KayuranN/EEE4022S_PrecisonHerbicideSprayer/README.md

# EEE4022S_PrecisonHerbicideSprayer
Repository containing all files used in the project development of the Precision Herbicide Sprayer
