KayuranN/EEE4022S_PrecisonHerbicideSprayer/Modeled Components/Camera System/AssemblyofGears.SLDASM

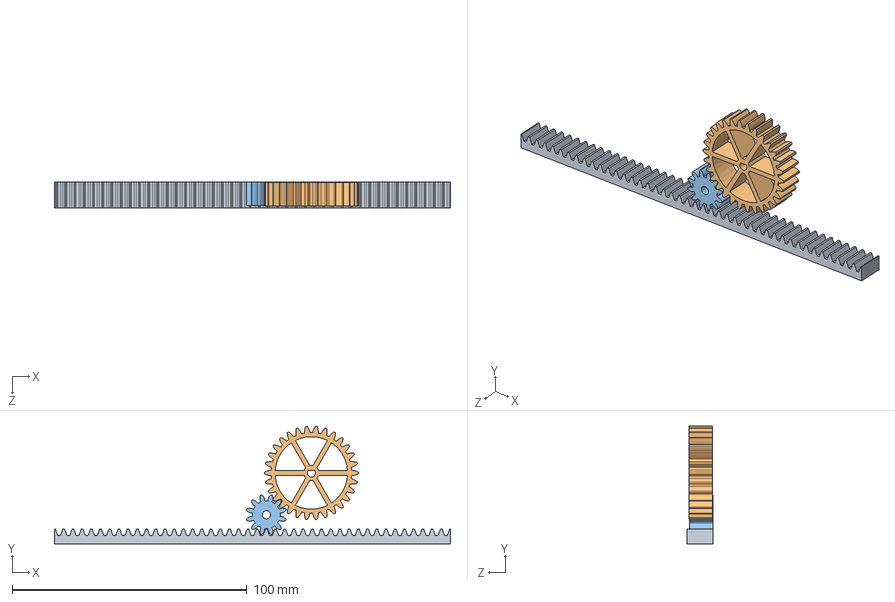
[picture p43: CAD file, 2023-10-29]
Modeled Components/Camera System/AssemblyofGears.SLDASM
168.9 x 50.1 x 11.0 mm
Rack169cm
BigGear
SmallGear
