KayuranN/EEE4022S_PrecisonHerbicideSprayer/Modeled Components/Actuation Arms/armReference.STL

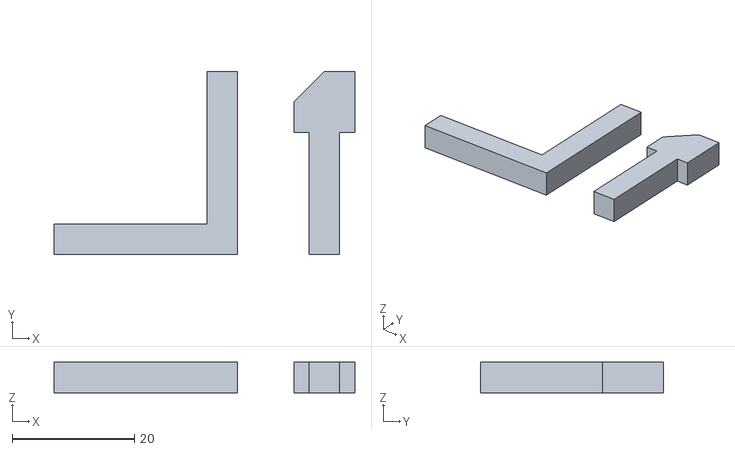
[picture p44: CAD file, 2023-10-29]
Modeled Components/Actuation Arms/armReference.STL
49.2 x 30.0 x 5.00
