KayuranN/EEE4022S_PrecisonHerbicideSprayer/Modeled Components/Uncategorized Parts/TPipeConnector.SLDPRT

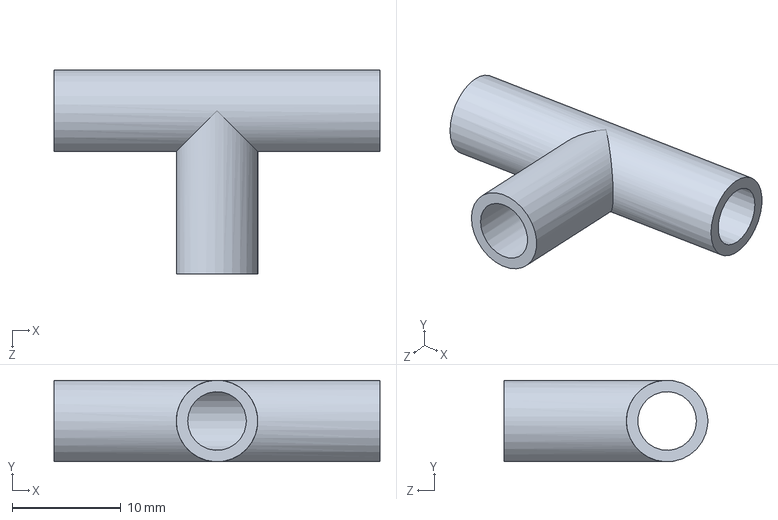
[picture p45: CAD file, 2023-10-29]
Modeled Components/Uncategorized Parts/TPipeConnector.SLDPRT
30.0 x 7.50 x 18.8 mm
