KayuranN/EEE4022S_PrecisonHerbicideSprayer/Modeled Components/Actuation Arms/housingBoxV2.2.SLDPRT

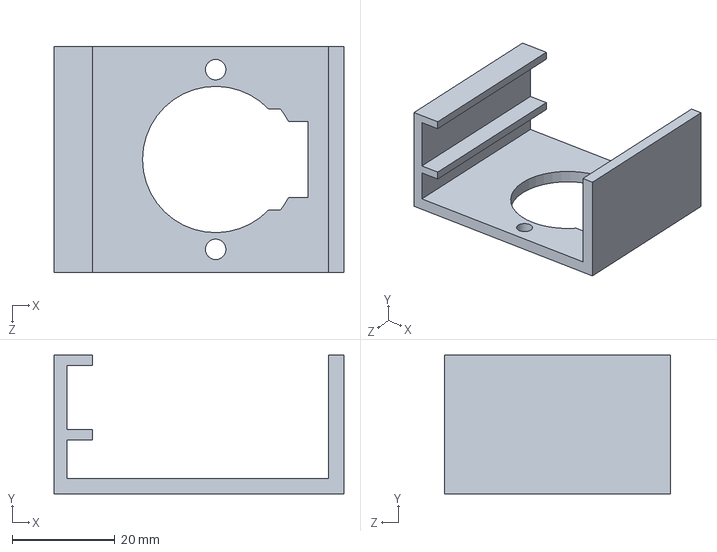
[picture p46: CAD file, 2023-10-29]
Modeled Components/Actuation Arms/housingBoxV2.2.SLDPRT
56.5 x 27.0 x 44.0 mm
