KayuranN/EEE4022S_PrecisonHerbicideSprayer/Modeled Components/Camera System/BigGear.SLDPRT

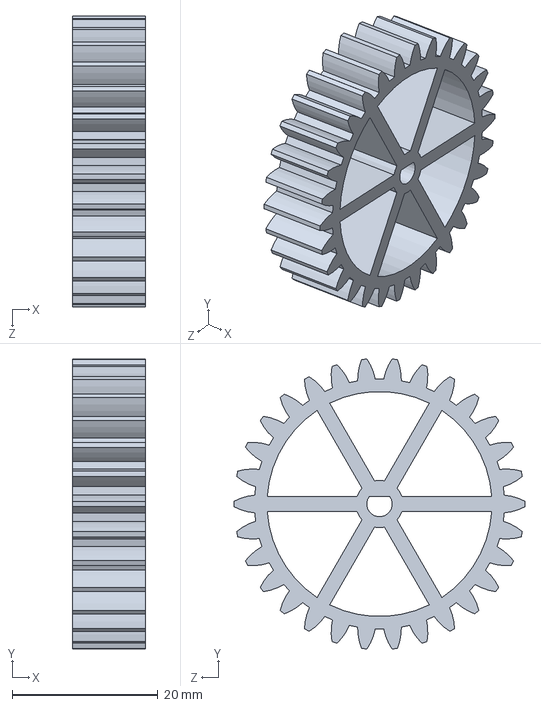
[picture p47: CAD file, 2023-10-29]
Modeled Components/Camera System/BigGear.SLDPRT
10.0 x 39.9 x 40.0 mm
