KayuranN/EEE4022S_PrecisonHerbicideSprayer/Modeled Components/Uncategorized Parts/wheelholder.SLDPRT

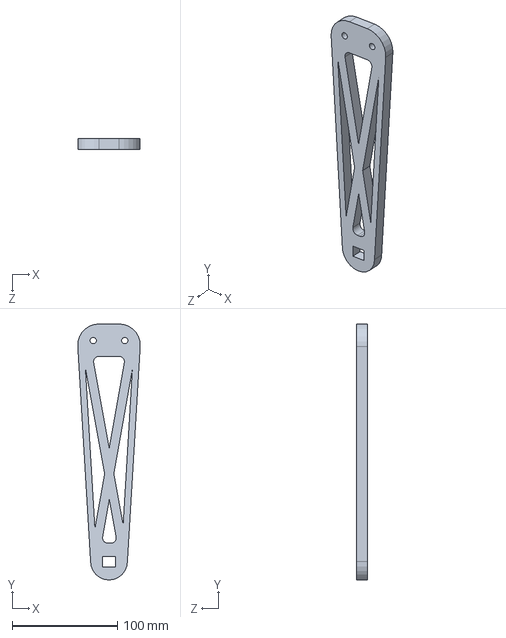
[picture p48: CAD file, 2023-10-29]
Modeled Components/Uncategorized Parts/wheelholder.SLDPRT
59.4 x 243.3 x 10.0 mm
