KayuranN/EEE4022S_PrecisonHerbicideSprayer/Modeled Components/Actuation Arms/MotorHolder.SLDPRT

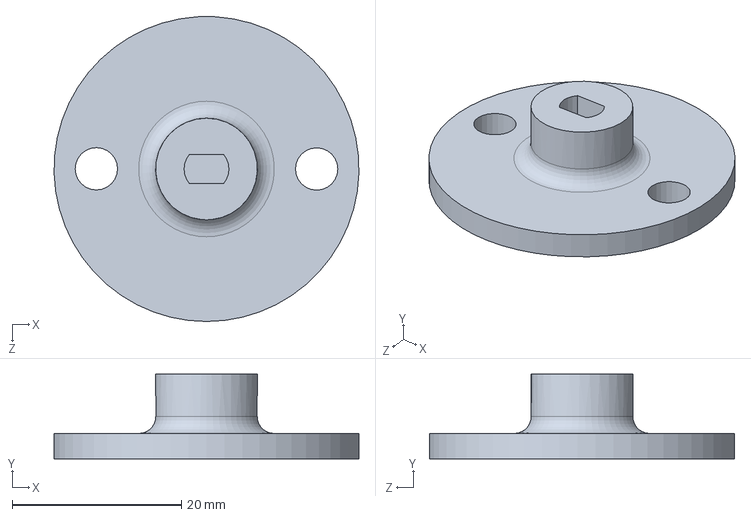
[picture p49: CAD file, 2023-10-29]
Modeled Components/Actuation Arms/MotorHolder.SLDPRT
36.0 x 10.0 x 36.0 mm
