KayuranN/EEE4022S_PrecisonHerbicideSprayer/Modeled Components/Camera System/MotorHolder.SLDPRT

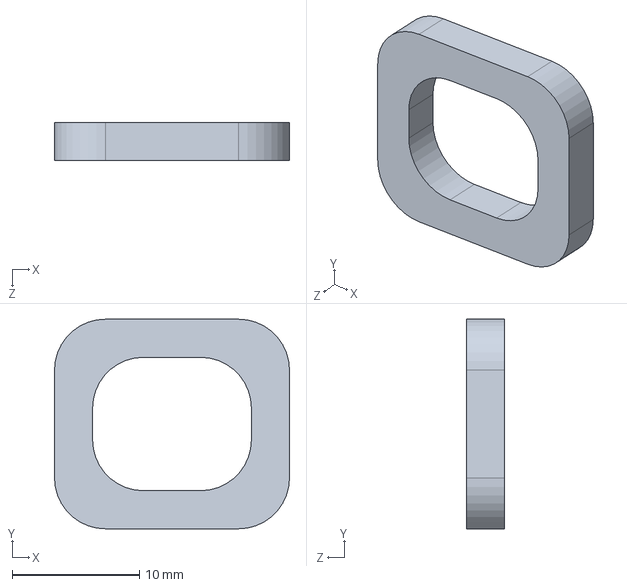
[picture p50: CAD file, 2023-10-29]
Modeled Components/Camera System/MotorHolder.SLDPRT
18.5 x 16.5 x 3.00 mm
