KayuranN/EEE4022S_PrecisonHerbicideSprayer/Modeled Components/Uncategorized Parts/wheelholderEnd.SLDPRT

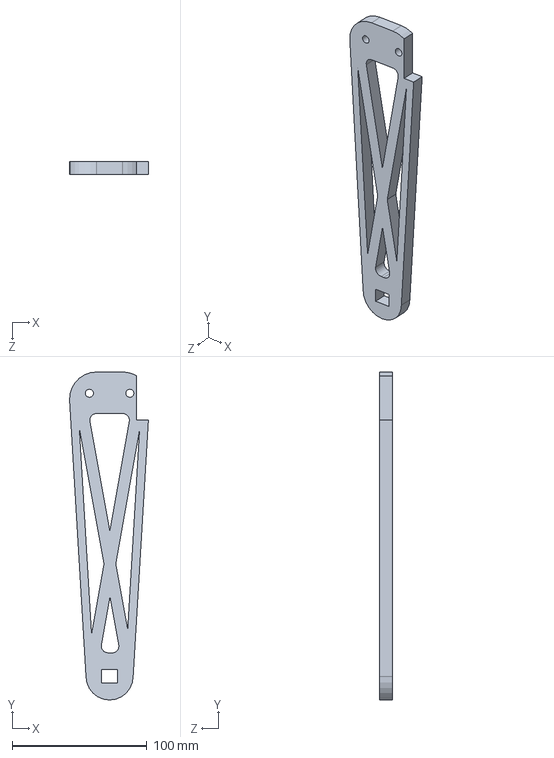
[picture p51: CAD file, 2023-10-29]
Modeled Components/Uncategorized Parts/wheelholderEnd.SLDPRT
58.5 x 243.3 x 10.0 mm
