KayuranN/EEE4022S_PrecisonHerbicideSprayer/Modeled Components/Actuation Arms/RackV3.2.STL

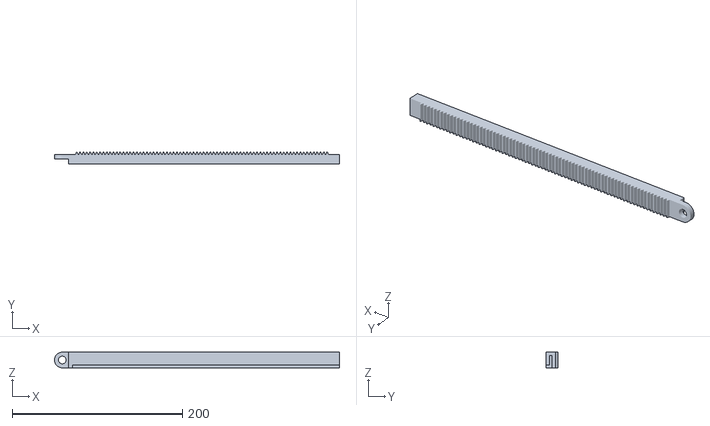
[picture p52: CAD file, 2023-10-29]
Modeled Components/Actuation Arms/RackV3.2.STL
335.2 x 14.2 x 18.5
