KayuranN/EEE4022S_PrecisonHerbicideSprayer/Modeled Components/Camera System/Rack169cm.SLDPRT

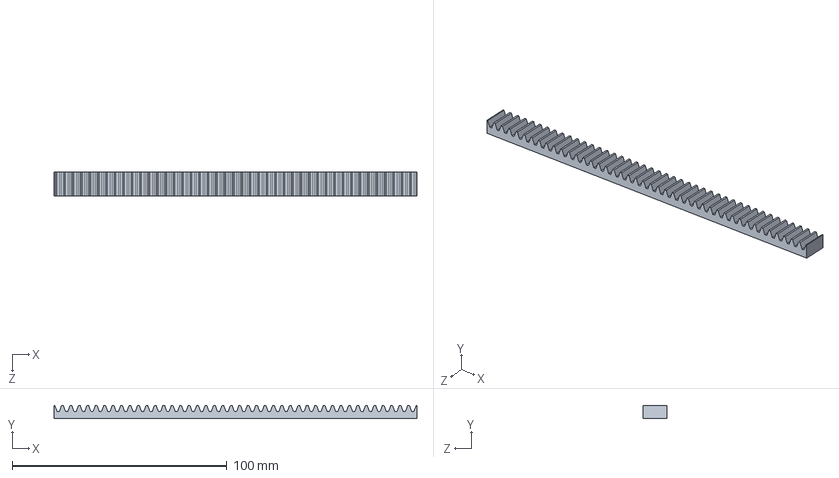
[picture p53: CAD file, 2023-10-29]
Modeled Components/Camera System/Rack169cm.SLDPRT
168.9 x 6.25 x 11.0 mm
