KayuranN/EEE4022S_PrecisonHerbicideSprayer/Modeled Components/Uncategorized Parts/wheelholderMiddle.SLDPRT

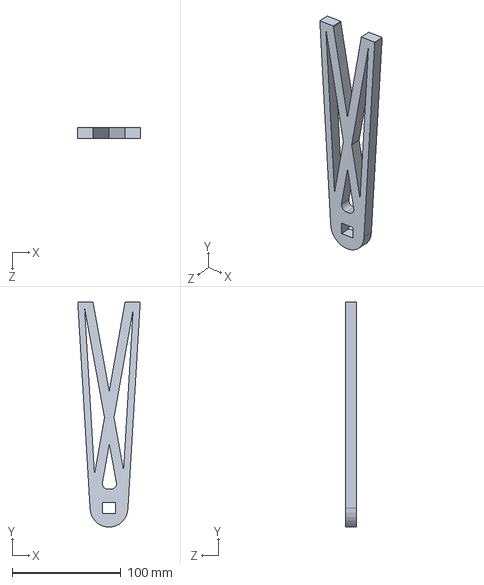
[picture p54: CAD file, 2023-10-29]
Modeled Components/Uncategorized Parts/wheelholderMiddle.SLDPRT
57.6 x 207.4 x 10.0 mm
