KayuranN/EEE4022S_PrecisonHerbicideSprayer/Modeled Components/Actuation Arms/rotationalHousing.SLDPRT

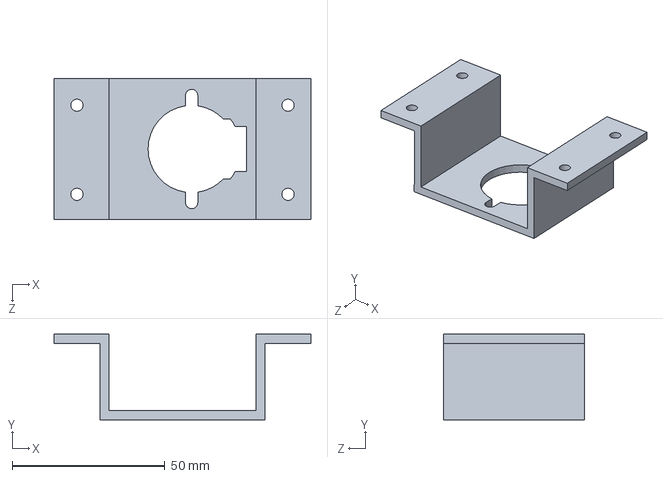
[picture p55: CAD file, 2023-10-29]
Modeled Components/Actuation Arms/rotationalHousing.SLDPRT
84.0 x 28.0 x 46.0 mm
