KayuranN/EEE4022S_PrecisonHerbicideSprayer/Modeled Components/Camera System/housingUnitUnder.SLDPRT

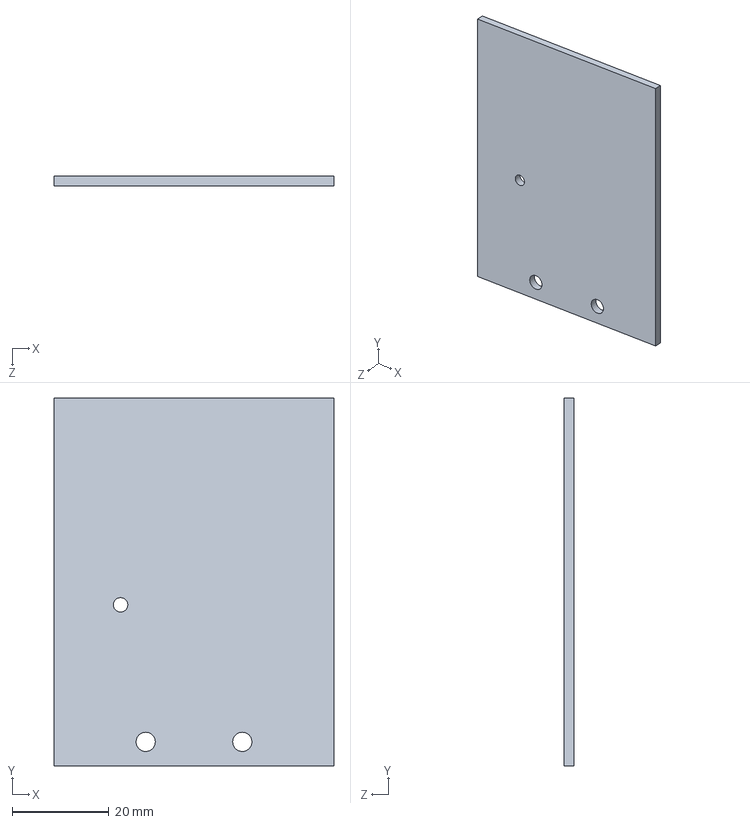
[picture p56: CAD file, 2023-10-29]
Modeled Components/Camera System/housingUnitUnder.SLDPRT
57.9 x 76.2 x 2.00 mm
