KayuranN/EEE4022S_PrecisonHerbicideSprayer/Modeled Components/Uncategorized Parts/Nozzle+.SLDPRT

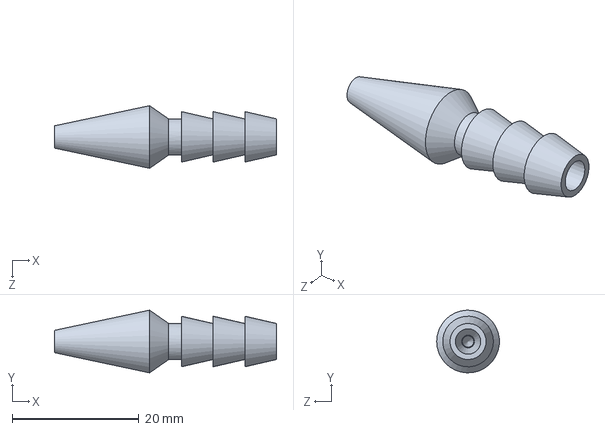
[picture p57: CAD file, 2023-10-29]
Modeled Components/Uncategorized Parts/Nozzle+.SLDPRT
35.0 x 9.89 x 9.88 mm
