KayuranN/EEE4022S_PrecisonHerbicideSprayer/Modeled Components/Actuation Arms/rotationalHousingShort.SLDPRT

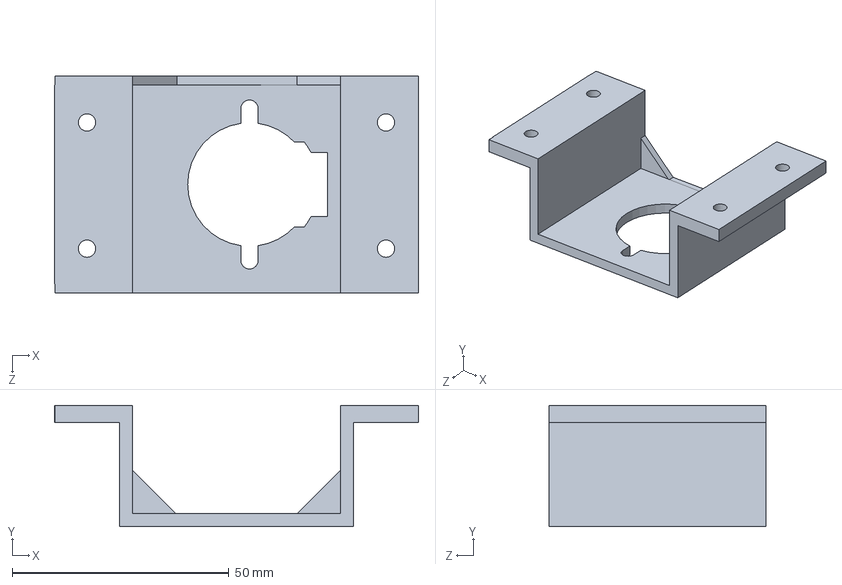
[picture p58: CAD file, 2023-10-29]
Modeled Components/Actuation Arms/rotationalHousingShort.SLDPRT
84.0 x 28.0 x 50.0 mm
