KayuranN/EEE4022S_PrecisonHerbicideSprayer/Modeled Components/Camera System/Slider.SLDPRT

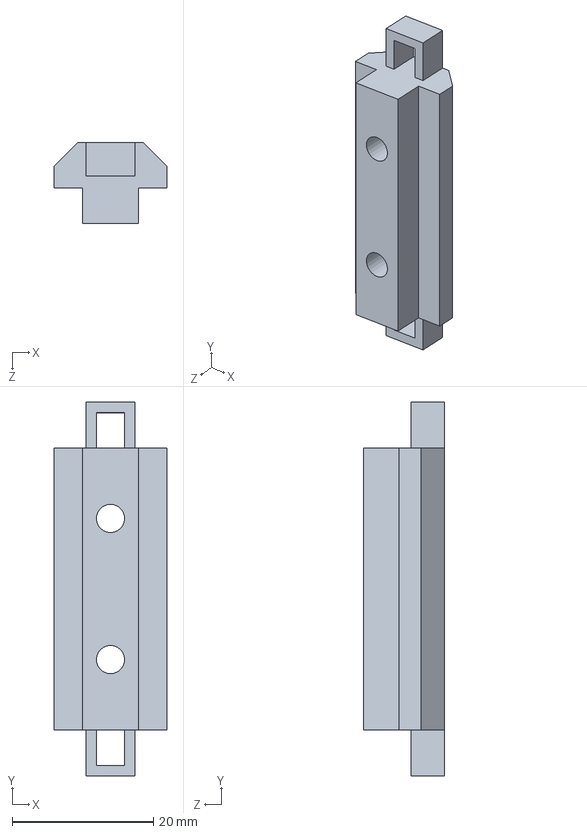
[picture p59: CAD file, 2023-10-29]
Modeled Components/Camera System/Slider.SLDPRT
16.0 x 53.0 x 11.5 mm
