KayuranN/EEE4022S_PrecisonHerbicideSprayer/Modeled Components/Actuation Arms/rotationalHousingTall.SLDPRT

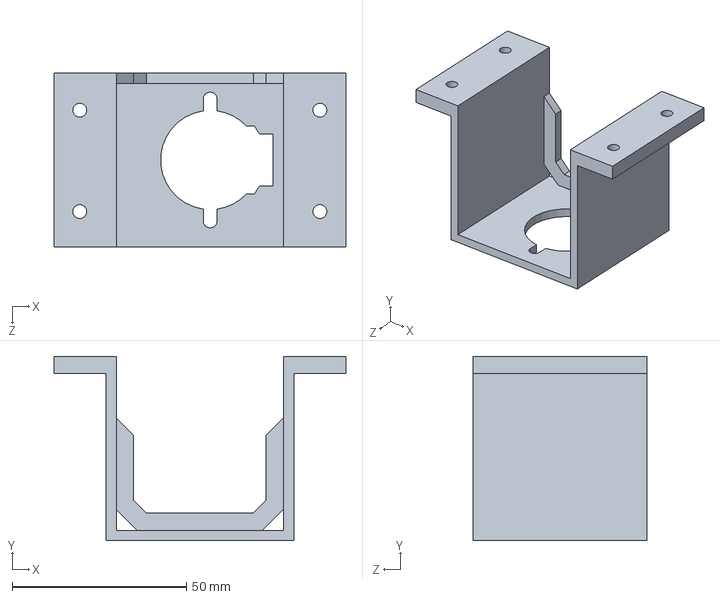
[picture p60: CAD file, 2023-10-29]
Modeled Components/Actuation Arms/rotationalHousingTall.SLDPRT
83.9 x 53.0 x 50.0 mm
