KayuranN/EEE4022S_PrecisonHerbicideSprayer/Modeled Components/Camera System/RawGears2.SLDPRT

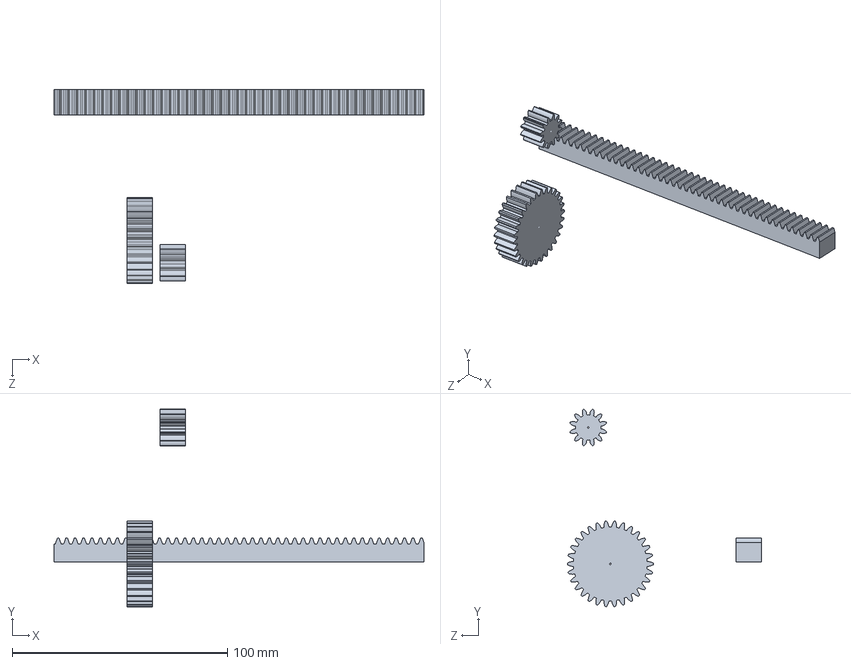
[picture p61: CAD file, 2023-10-29]
Modeled Components/Camera System/RawGears2.SLDPRT
172.0 x 91.9 x 90.4 mm
