KayuranN/EEE4022S_PrecisonHerbicideSprayer/Modeled Components/Uncategorized Parts/LPipeConnector.SLDPRT

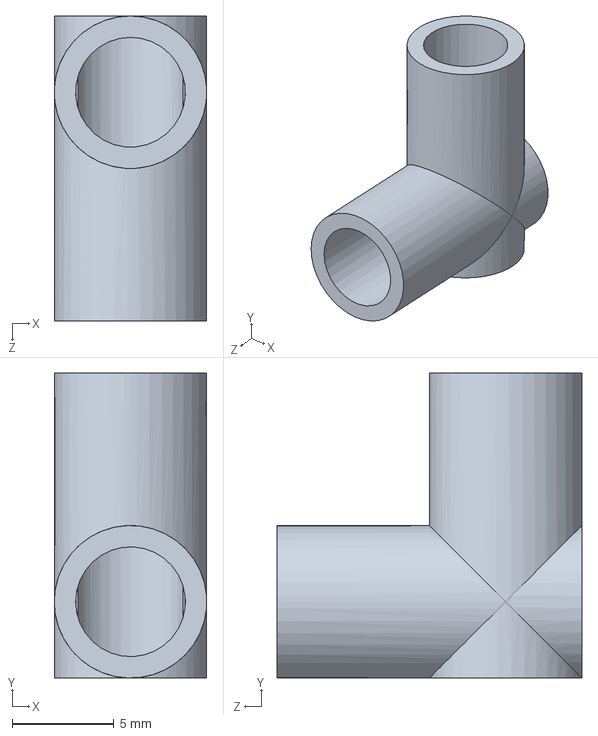
[picture p62: CAD file, 2023-10-29]
Modeled Components/Uncategorized Parts/LPipeConnector.SLDPRT
7.50 x 15.0 x 15.0 mm
