KayuranN/EEE4022S_PrecisonHerbicideSprayer/Modeled Components/Actuation Arms/RackKey.SLDPRT

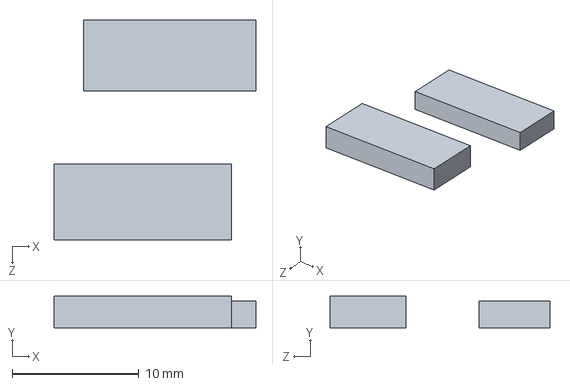
[picture p63: CAD file, 2023-10-29]
Modeled Components/Actuation Arms/RackKey.SLDPRT
15.9 x 2.50 x 17.4 mm
