KayuranN/EEE4022S_PrecisonHerbicideSprayer/Modeled Components/Camera System/rackHolder1mmshorter.SLDPRT

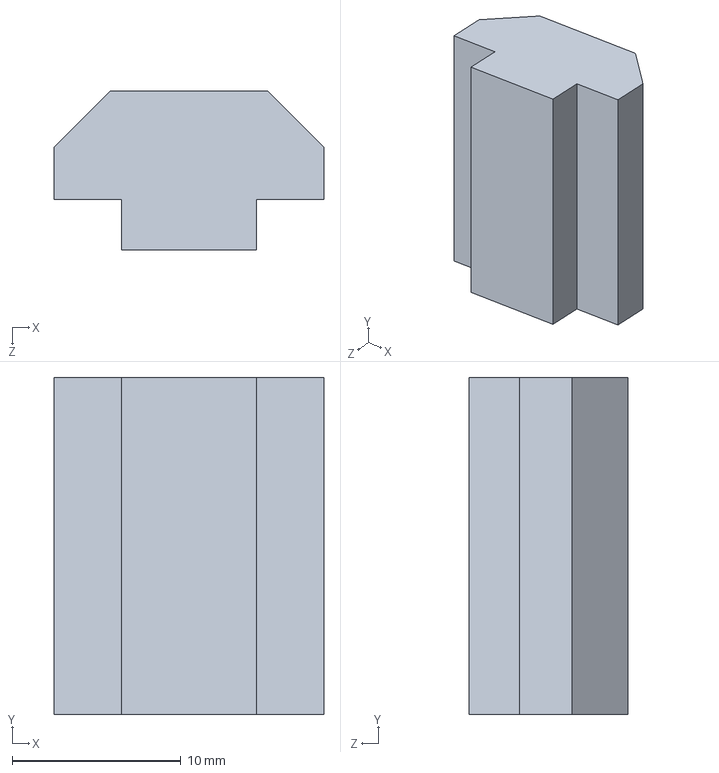
[picture p64: CAD file, 2023-10-29]
Modeled Components/Camera System/rackHolder1mmshorter.SLDPRT
16.0 x 20.0 x 9.46 mm
