KayuranN/EEE4022S_PrecisonHerbicideSprayer/Modeled Components/Actuation Arms/RackAndPinionV2.2.SLDPRT

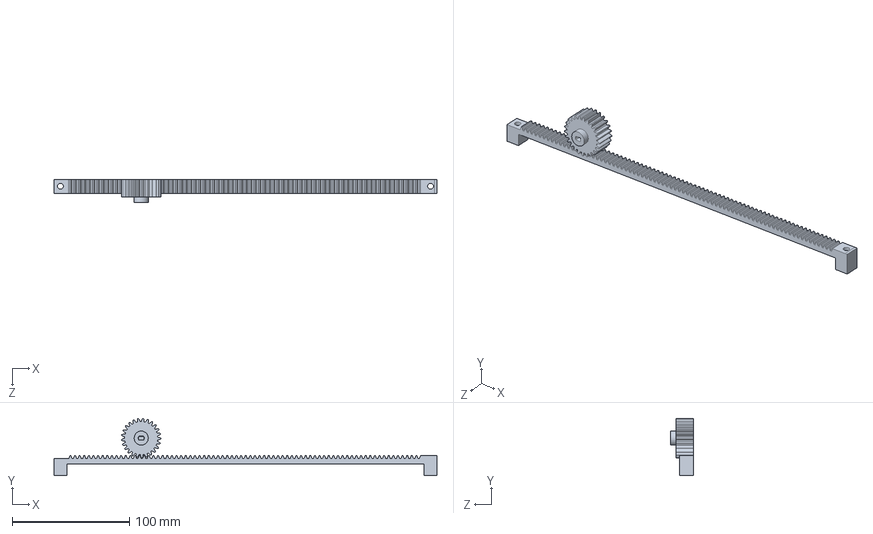
[picture p65: CAD file, 2023-10-29]
Modeled Components/Actuation Arms/RackAndPinionV2.2.SLDPRT
326.0 x 48.8 x 20.0 mm
