KayuranN/EEE4022S_PrecisonHerbicideSprayer/Modeled Components/Camera System/housingUnit.SLDPRT

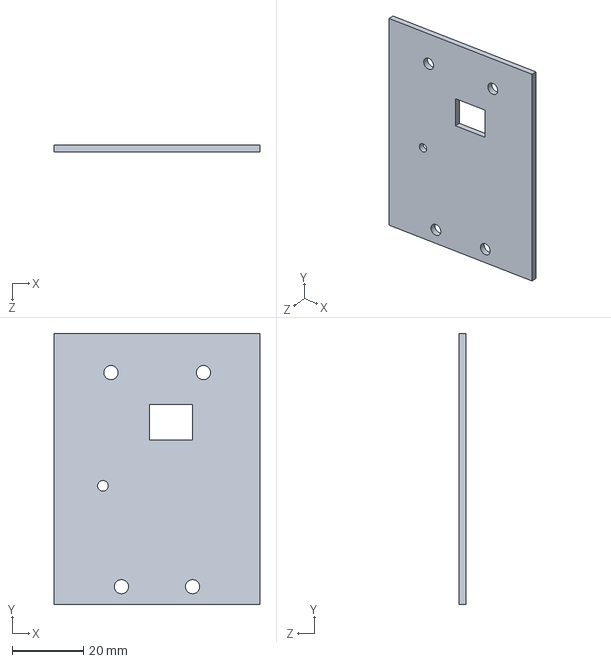
[picture p66: CAD file, 2023-10-29]
Modeled Components/Camera System/housingUnit.SLDPRT
57.9 x 76.2 x 2.00 mm
