KayuranN/EEE4022S_PrecisonHerbicideSprayer/Modeled Components/Uncategorized Parts/NozzleBlank.SLDPRT

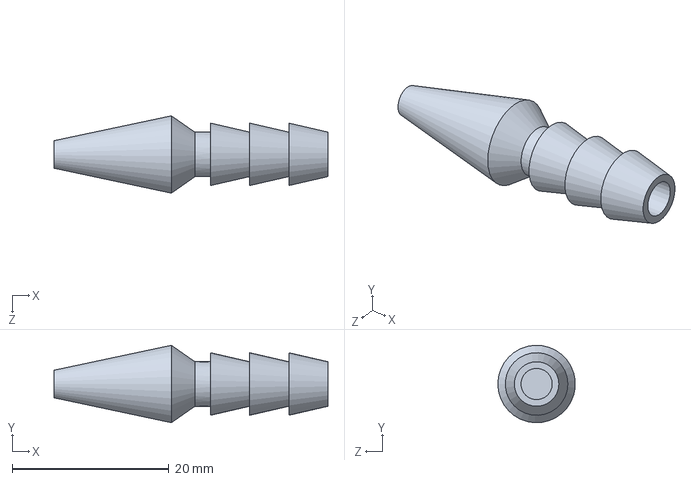
[picture p67: CAD file, 2023-10-29]
Modeled Components/Uncategorized Parts/NozzleBlank.SLDPRT
35.0 x 9.89 x 9.88 mm
