KayuranN/EEE4022S_PrecisonHerbicideSprayer/Modeled Components/Camera System/RawGears.SLDPRT

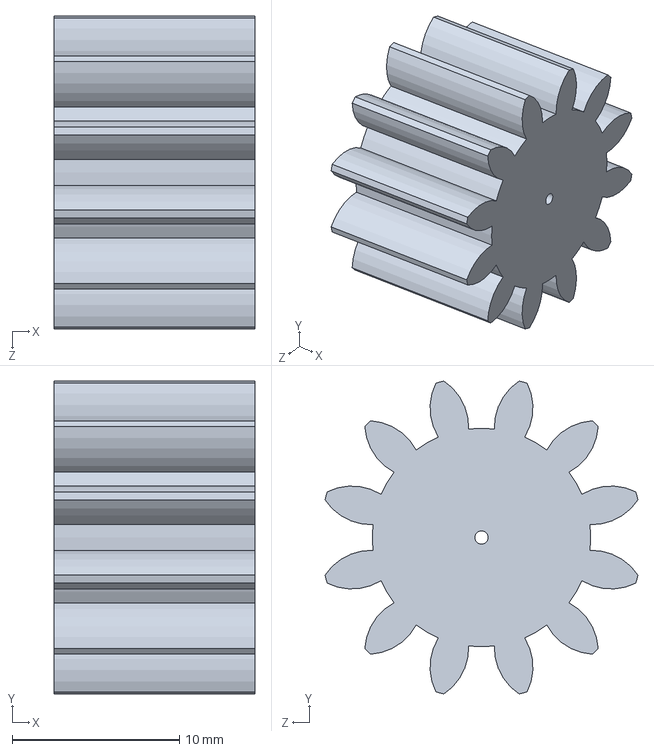
[picture p68: CAD file, 2023-10-29]
Modeled Components/Camera System/RawGears.SLDPRT
12.0 x 18.7 x 18.7 mm
