KayuranN/EEE4022S_PrecisonHerbicideSprayer/Modeled Components/Camera System/rackHolder.SLDPRT

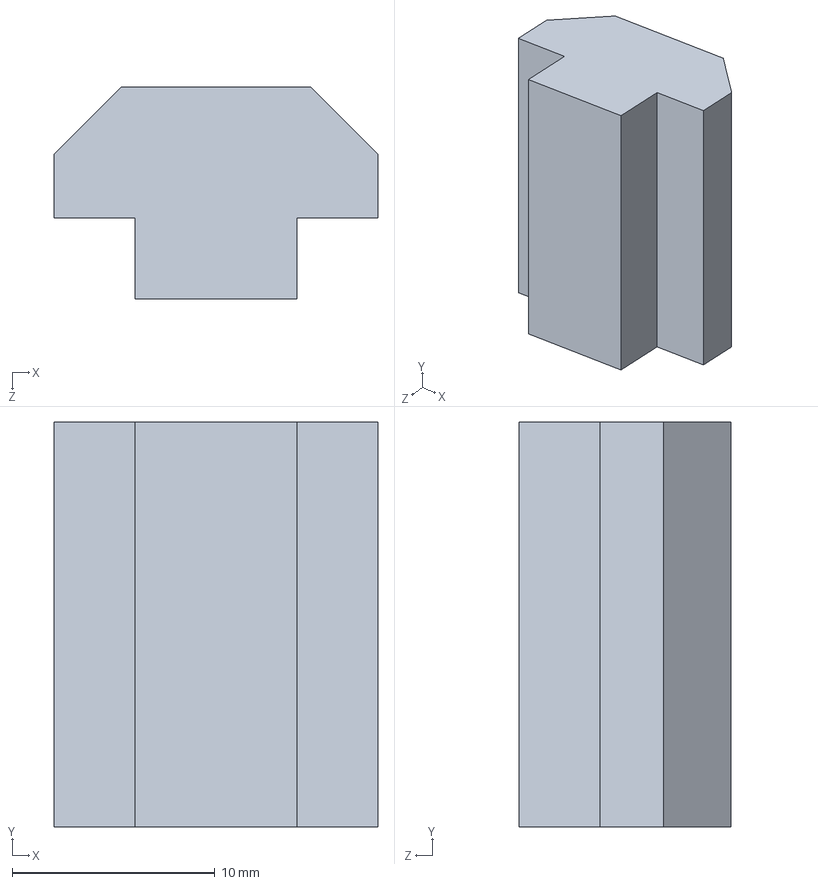
[picture p69: CAD file, 2023-10-29]
Modeled Components/Camera System/rackHolder.SLDPRT
16.0 x 20.0 x 10.5 mm
