KayuranN/EEE4022S_PrecisonHerbicideSprayer/Modeled Components/Camera System/SmallGear.SLDPRT

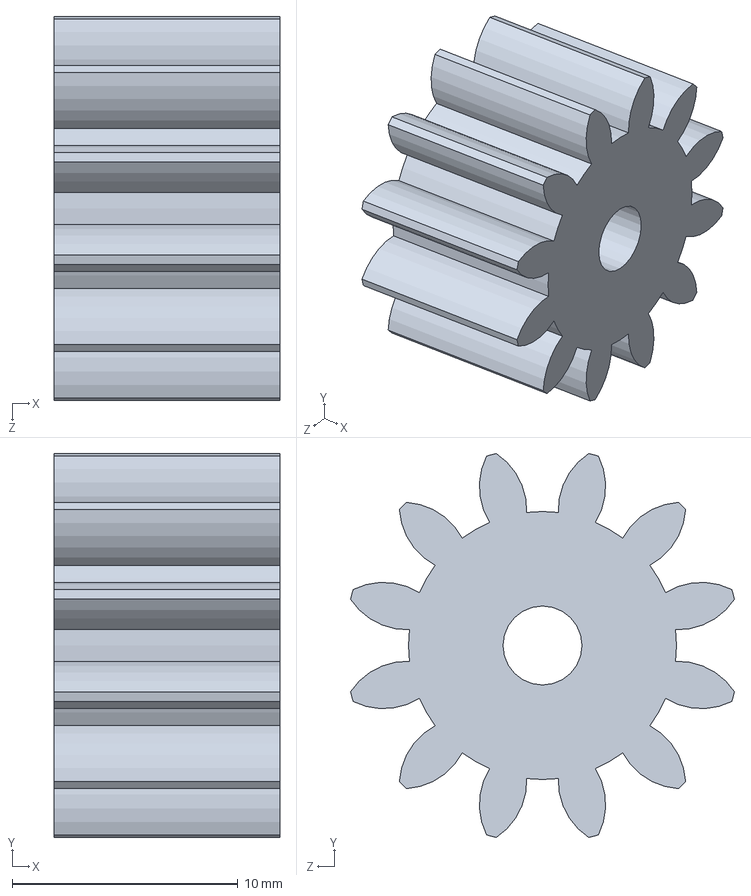
[picture p70: CAD file, 2023-10-29]
Modeled Components/Camera System/SmallGear.SLDPRT
10.0 x 17.0 x 17.0 mm
