KayuranN/EEE4022S_PrecisonHerbicideSprayer/Modeled Components/Uncategorized Parts/wheelholderInner.SLDPRT

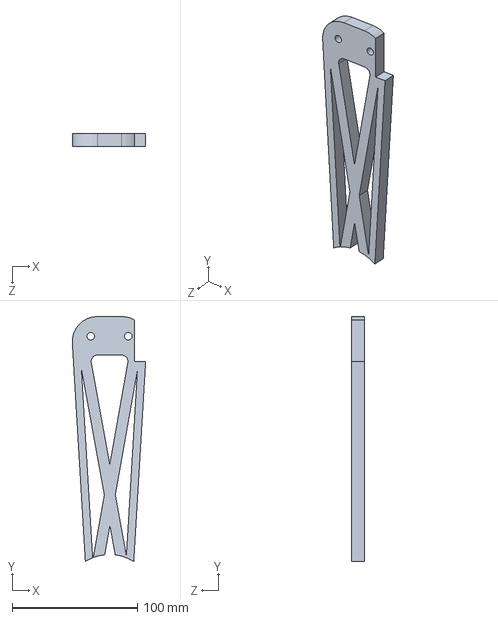
[picture p71: CAD file, 2023-10-29]
Modeled Components/Uncategorized Parts/wheelholderInner.SLDPRT
58.5 x 195.4 x 10.0 mm
