KayuranN/EEE4022S_PrecisonHerbicideSprayer/Modeled Components/Uncategorized Parts/Nozzle2.5x0.4.SLDPRT

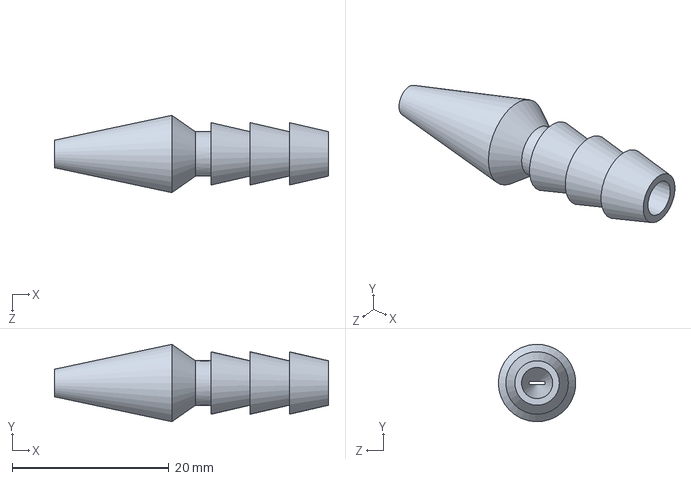
[picture p72: CAD file, 2023-10-29]
Modeled Components/Uncategorized Parts/Nozzle2.5x0.4.SLDPRT
35.0 x 9.89 x 9.88 mm
