KayuranN/EEE4022S_PrecisonHerbicideSprayer/Modeled Components/Uncategorized Parts/wheelholderInside.SLDPRT

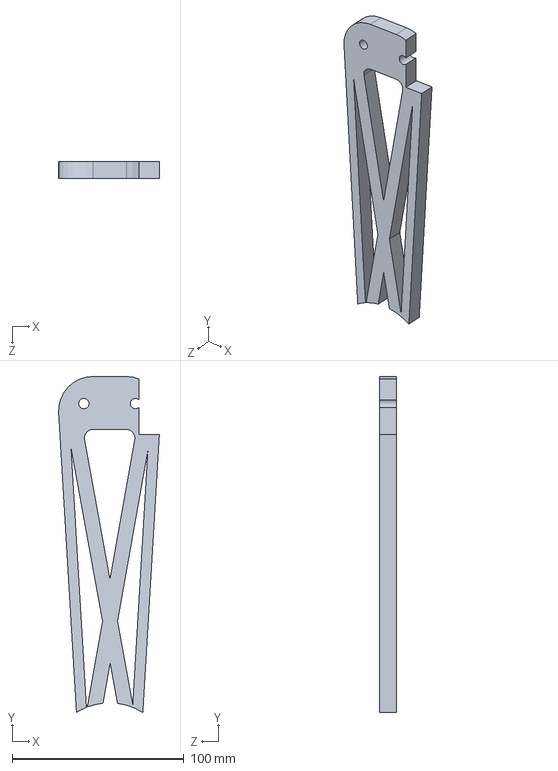
[picture p73: CAD file, 2023-10-29]
Modeled Components/Uncategorized Parts/wheelholderInside.SLDPRT
58.6 x 195.4 x 10.0 mm
