KayuranN/EEE4022S_PrecisonHerbicideSprayer/(list of files, cad)

Other CAD files:
Modeled Components/Uncategorized Parts/Nozzle2.5mm.SLDPRT
Modeled Components/Uncategorized Parts/Nozzle2mm.SLDPRT
Modeled Components/Uncategorized Parts/Nozzle1.5mm.SLDPRT
Modeled Components/Uncategorized Parts/wheelholderInsideEdge.SLDPRT
Modeled Components/Uncategorized Parts/Nozzle2.5x0.8.SLDPRT
Modeled Components/Uncategorized Parts/Nozzle1mm.SLDPRT
Modeled Components/Actuation Arms/MotorHolder.STL
Modeled Components/Actuation Arms/RackAndPinionV2.2.STL
Modeled Components/Actuation Arms/RackKey.STL
Modeled Components/Actuation Arms/housingBoxV2.2.STL
Modeled Components/Actuation Arms/rotationalHousing.STL
Modeled Components/Actuation Arms/rotationalHousingShort.STL
Modeled Components/Actuation Arms/rotationalHousingTall.STL
Modeled Components/Camera System/BigGear.STL
Modeled Components/Camera System/MotorHolder.STL
Modeled Components/Camera System/Rack169cm.STL
Modeled Components/Camera System/Slider.STL
Modeled Components/Camera System/SmallGear.STL
Modeled Components/Camera System/rackHolder.STL
Modeled Components/Camera System/rackHolder1mmshorter.STL
Modeled Components/Uncategorized Parts/LPipeConnector.STL
Modeled Components/Uncategorized Parts/Nozzle+.STL
Modeled Components/Uncategorized Parts/Nozzle1.5mm.STL
Modeled Components/Uncategorized Parts/Nozzle1mm.STL
Modeled Components/Uncategorized Parts/Nozzle2.5mm.STL
Modeled Components/Uncategorized Parts/Nozzle2.5x0.4.STL
Modeled Components/Uncategorized Parts/Nozzle2.5x0.8.STL
Modeled Components/Uncategorized Parts/Nozzle2mm.STL
Modeled Components/Uncategorized Parts/TPipeConnector.STL
