KayuranN/EEE4022S_PrecisonHerbicideSprayer/Modeled Components/Uncategorized Parts/wheelholder.pdf

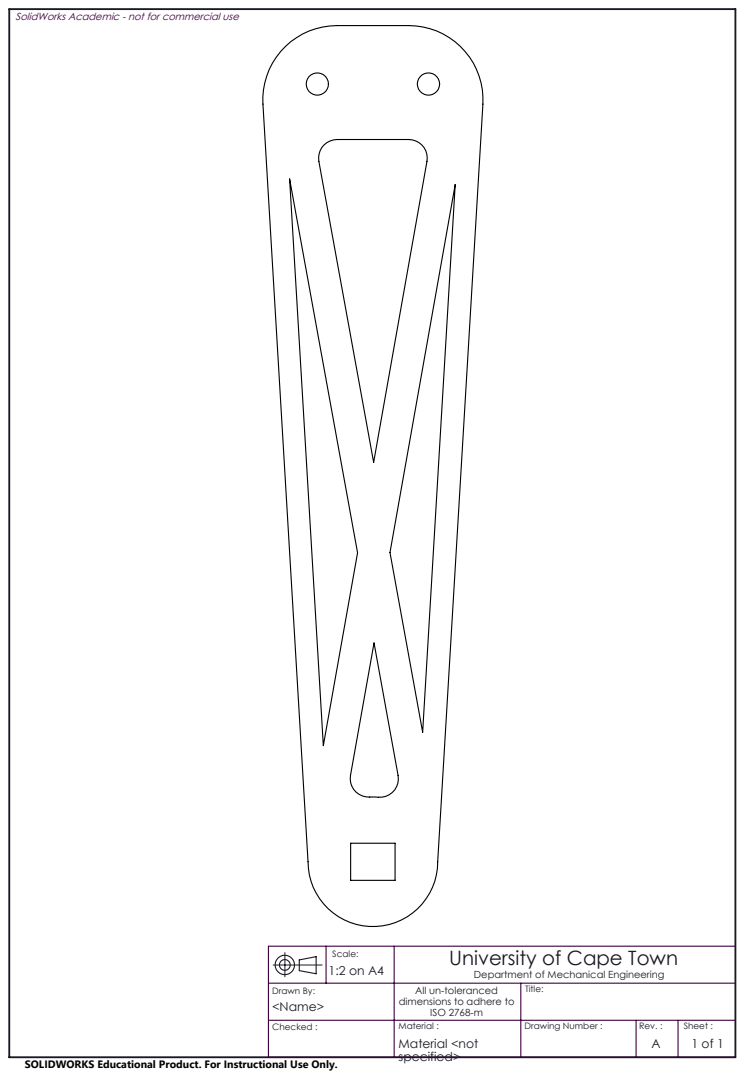
[picture p74: page 1]

SolidWorks Academic - not for commercial use

Scale: 1:2 on A4 | University of Cape Town Department of Mechanical Engineering

Drawn By: <Name> | All un-toleranced dimensions to adhere to ISO 2768-m | Title:

Checked : | Material : Material <not | Drawing Number : | Rev. : A | Sheet :

SOLIDWORKS Educational Product. For Instructional Use Only.
