KayuranN/EEE4022S_PrecisonHerbicideSprayer/Arduino Code Files/HuskylensData.ino

#include "HUSKYLENS.h"
#include "SoftwareSerial.h"

const int E1 = 5; ///<Motor1 Speed
const int M1 = 4; ///<Motor1 Direction

HUSKYLENS huskylens;
SoftwareSerial mySerial(10, 11); // RX, TX
//HUSKYLENS green line >> Pin 10; blue line >> Pin 11
void printResult(HUSKYLENSResult result);

void M1_advance(char Speed) ///<Motor1 Advance
{
 digitalWrite(M1,LOW);
 analogWrite(E1,Speed);
}

void M1_back(char Speed) ///<Motor1 Back off
{
 digitalWrite(M1,HIGH);
 analogWrite(E1,Speed);
}


void setup() {
    for(int i=3;i<9;i++)
    pinMode(i,OUTPUT);
    Serial.begin(115200);
    mySerial.begin(9600);
    while (!huskylens.begin(mySerial))
    {
        Serial.println(F("Begin failed!"));
        Serial.println(F("1.Please recheck the \"Protocol Type\" in HUSKYLENS (General Settings>>Protocol Type>>Serial 9600)"));
        Serial.println(F("2.Please recheck the connection."));
        delay(100);
    }
}

void loop() {
    if (!huskylens.request()) Serial.println(F("Fail to request data from HUSKYLENS, recheck the connection!"));
    else if(!huskylens.isLearned()) Serial.println(F("Nothing learned, press learn button on HUSKYLENS to learn one!"));
    else if(!huskylens.available()) Serial.println(F("No block or arrow appears on the screen!"));
    else
    {
        Serial.println(F("###########"));
        while (huskylens.available())
        {
            HUSKYLENSResult result = huskylens.read();
            HUSKYLENSResult Xcord = result.xCenter;
            printResult(result);
        }    
    }   
}

void printResult(HUSKYLENSResult result){
    if (result.command == COMMAND_RETURN_BLOCK){
        Serial.println(String()+F("Block:xCenter=")+result.xCenter+F(",yCenter=")+result.yCenter+F(",width=")+result.width+F(",height=")+result.height+F(",ID=")+result.ID);
    }
    else if (result.command == COMMAND_RETURN_ARROW){
        Serial.println(String()+F("Arrow:xOrigin=")+result.xOrigin+F(",yOrigin=")+result.yOrigin+F(",xTarget=")+result.xTarget+F(",yTarget=")+result.yTarget+F(",ID=")+result.ID);
    }
    else{
        Serial.println("Object unknown!");
    }
}
